UNF-IEEE-Student-Branch/RC-Surf-Rover/Motor-Controller/README.md

# Collection of files to understand the sabertooth functionality
Initial setup includes the sabertooths set up in single-byte serial control (Mode 4)
* Baud Rate of 38400
* Asynchronous Serial w/ 8 bits with no parity and 1 start/stop bit
* For Motor 1 value of 1 is full reverse, 64 is stop, and 127 is full reverse
* For Motor 2 value of 128 is full reverse, 192 is stop, and 255 is full forward

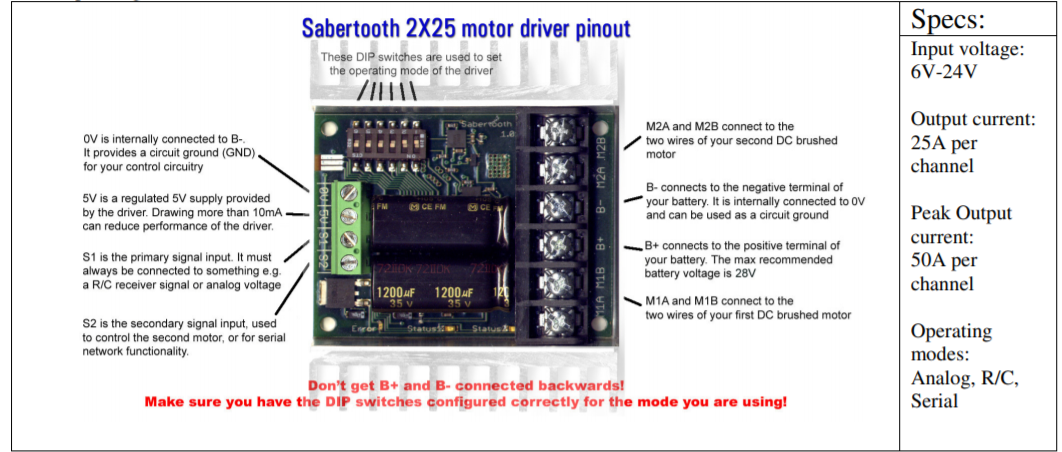
[picture p3: media/images/Sabertooth_Overview.png]
Sabertooth_Overview
