UNF-IEEE-Student-Branch/RC-Surf-Rover/Previous Reports/README.md

# All of the past datasheets and extra information needed to understand the project

## Datasheets we need
1. ~~Sabertooth 2x25 V2.00 Motor Controller~~
2. Arducopter w/ Power Module v1.0
