UNF-IEEE-Student-Branch/RC-Surf-Rover/media/images/IMG_3116.jpg

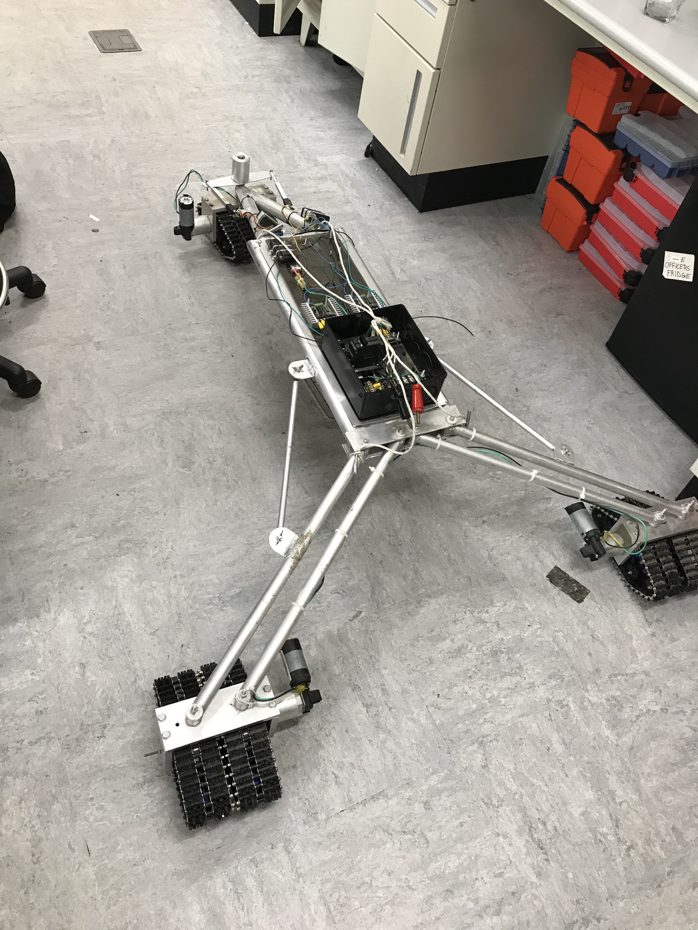
media/images/IMG_3116.jpg
