UNF-IEEE-Student-Branch/RC-Surf-Rover/media/images/IMG_3117.jpg

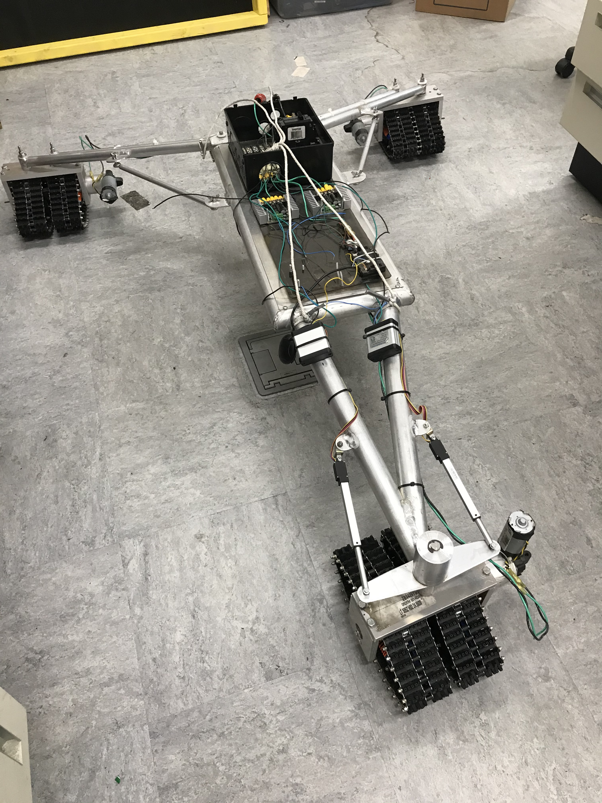
media/images/IMG_3117.jpg
