UNF-IEEE-Student-Branch/RC-Surf-Rover/media/images/IMG_3118.jpg

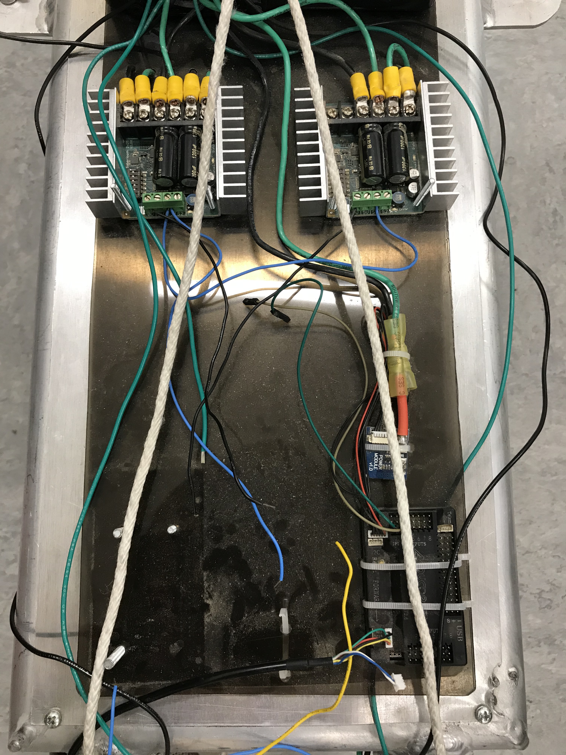
media/images/IMG_3118.jpg
