UNF-IEEE-Student-Branch/RC-Surf-Rover/media/images/IMG_3119.jpg

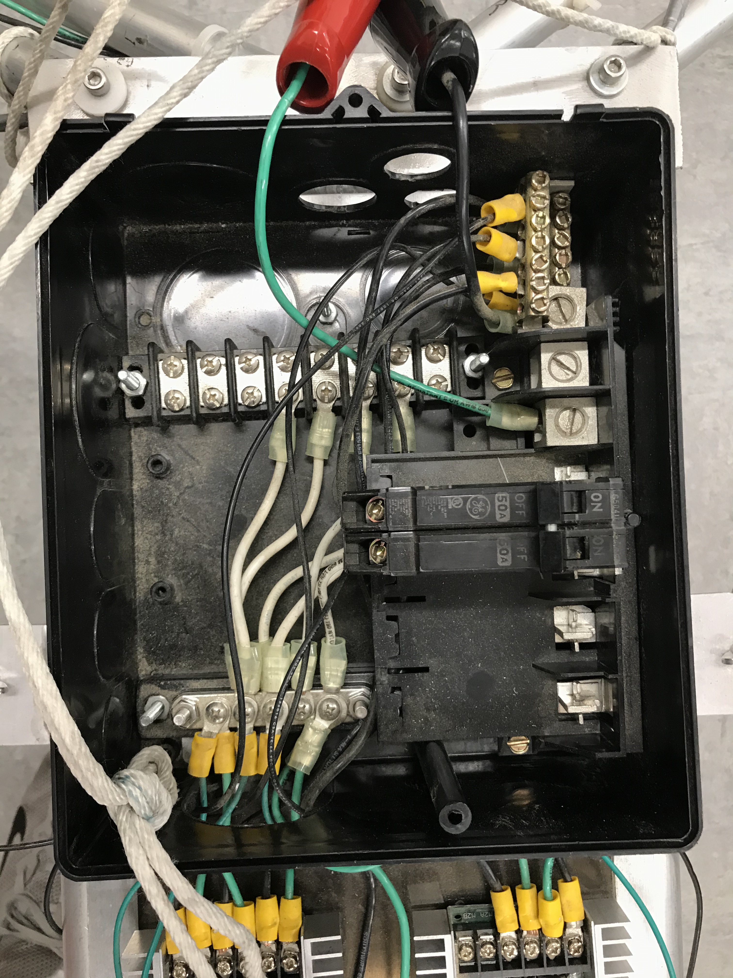
media/images/IMG_3119.jpg
