UNF-IEEE-Student-Branch/RC-Surf-Rover/media/images/IMG_3354.jpg

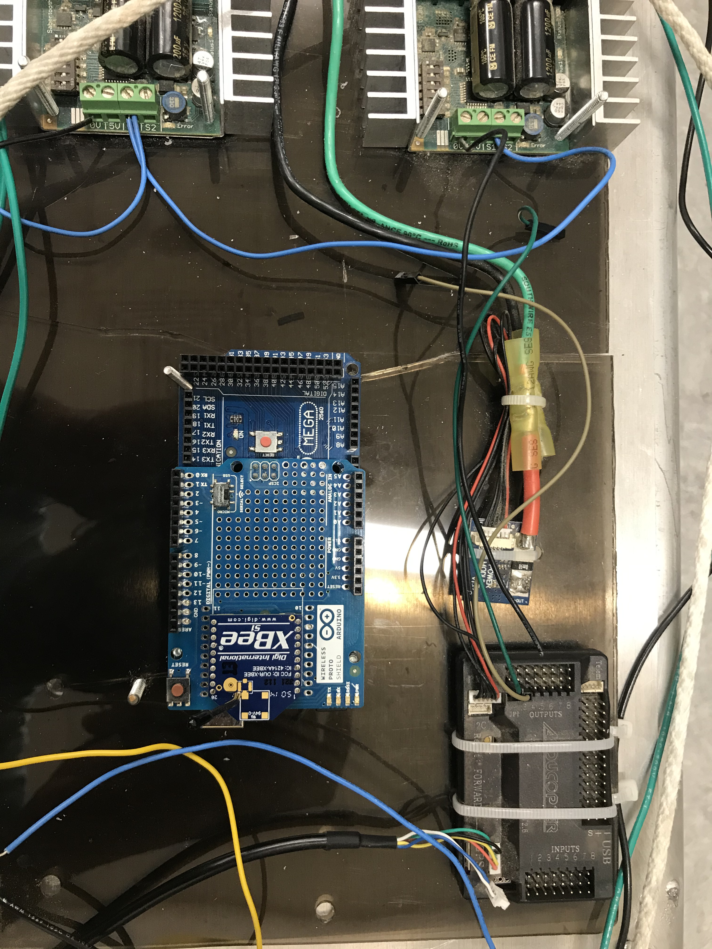
media/images/IMG_3354.jpg
